wilco2009/Videopac-micro-SD-Cart/pictures/screen.png

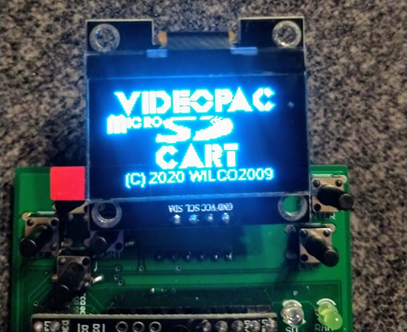
pictures/screen.png
