wilco2009/Videopac-micro-SD-Cart/(threads)

Thread 1 (2023-02-27):

Extra information for people creating the cartridge

JimmyDansbo, 2023-02-27:
Need a complete BOM for the cartridge ( I can't see what kind of RAM chip is used and I believe there is one or two resistors that do not have their value specified in the schematic ).
A guide to programming the CPLD and possibly even the Arduino the first time.
