wilco2009/Videopac-micro-SD-Cart/Schematics/Videopac SD cart 2.2 - alt.pdf

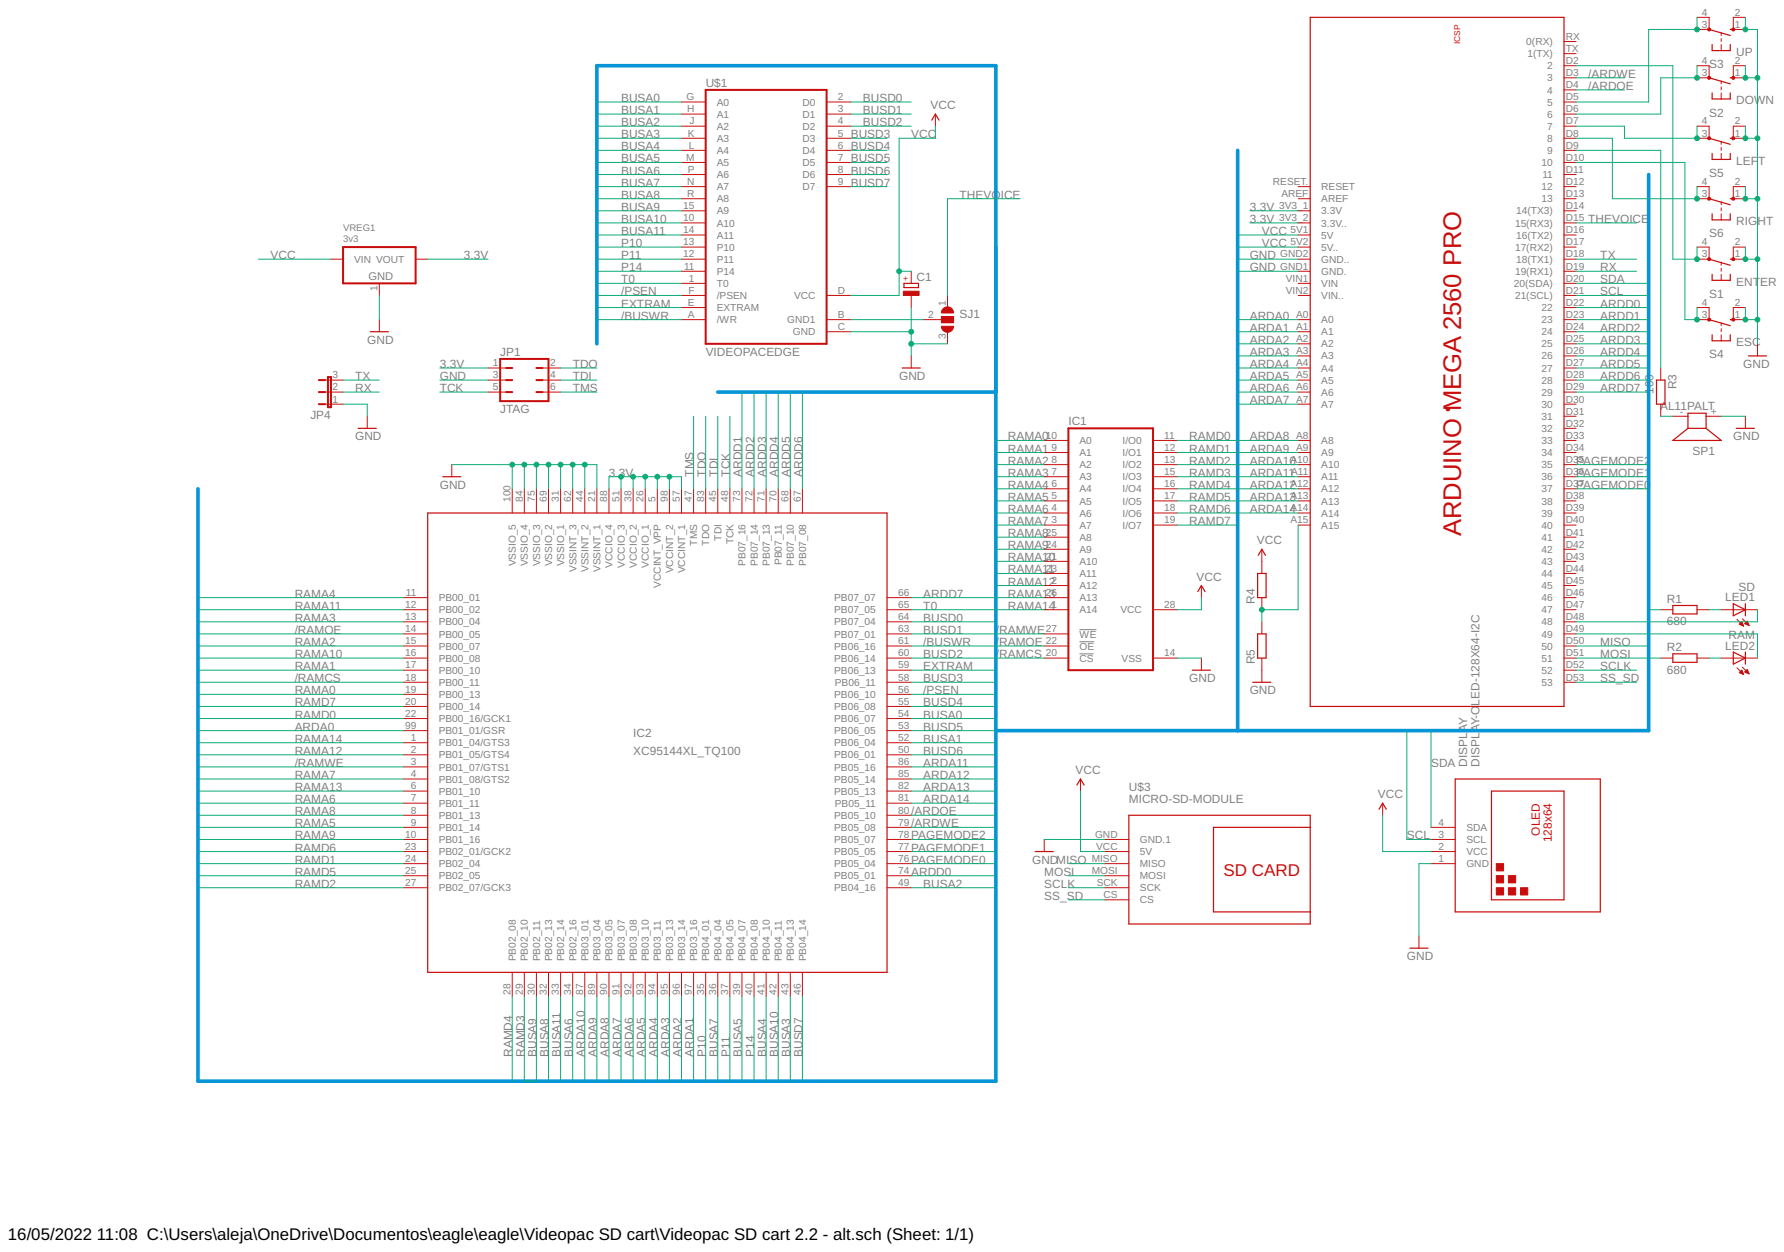
[picture p23: page 1]

BUSA4 | | 5 D4 BUSD4
L BUSA5 | A5 M | 6 D5 BUSD5

ARDA2 | ARDD3
ARDA3 | ARDD4
ARDA4 | ARDD5

RAMA1 | 59 PB06_14 EXTRAM | | GND
/RAMCS | 58 PB06_13 BUSD3
RAMA0 | 56 PB06_11 /PSEN
RAMD7 | 55 PB06_10 BUSD4
RAMD0 | 54 PB06_08 BUSA0
ARDA0 | 53 PB06_07 BUSD5
RAMA14 | 52 PB06_05 BUSA1 | VCC
RAMA12 | 50 PB06_04 BUSD6
/RAMWE | 86 PB06_01 ARDA11
RAMA7 | 85 PB05_16 ARDA12
RAMA13 | 82 PB05_14 ARDA13
RAMA6 | 81 PB05_13 ARDA14
RAMA8 | 80 PB05_11 /ARDOE

RAMD1 | 76 PB05_05 PAGEMODE0
RAMD5 | 74 PB05_04 ARDD0
RAMD2 | 49 PB05_01 BUSA2

16/05/2022 11:08 C:\Users\aleja\OneDrive\Documentos\eagle\eagle\Videopac SD cart\Videopac SD cart 2.2 - alt.sch (Sheet: 1/1)
