wilco2009/Videopac-micro-SD-Cart/Eagle/Videopac SD cart 2.2 - alt.brd

## EAGLE design Eagle/Videopac SD cart 2.2 - alt.brd (2022-12-12)

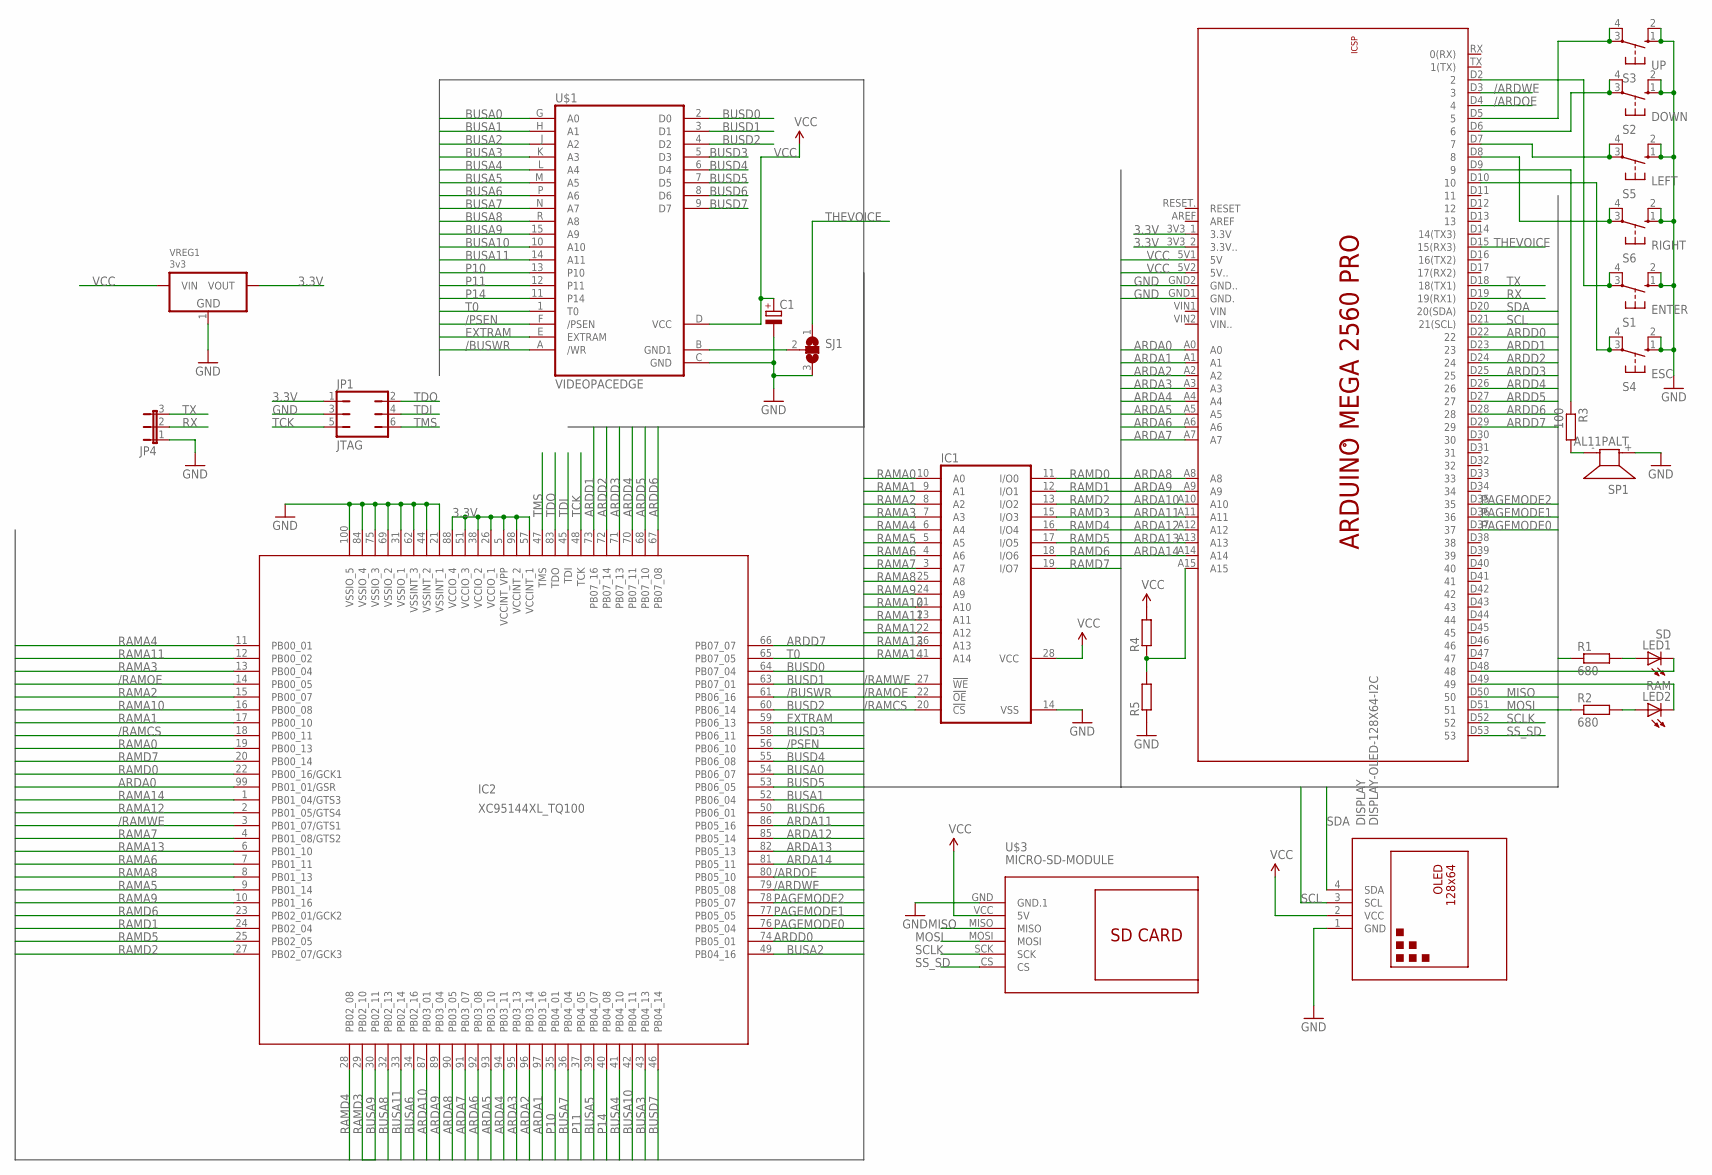
[picture p24: schematic Videopac SD cart 2.2 - alt.sch]

Parts:
C1: CPOL-EUE3.5-8; E3,5-8
DISPLAY: DISPLAY-OLED-128X64-I2C
IC1: 62256FPSOP28; SOP28
IC2: XC95144XL_TQ100; XC-TQ100
JP1: JTAG; JP3Q
JP4: JP2E; JP2
LED1: SD; LED3MM
LED2: RAM; LED3MM
R1, R2: 680; 0204/7
R3: 100; 0204/7
R4, R5: R-EU_0204/7; 0204/7
S1: ENTER; B3F-10XX
S2: DOWN; B3F-10XX
S3: UP; B3F-10XX
S4: ESC; B3F-10XX
S5: LEFT; B3F-10XX
S6: RIGHT; B3F-10XX
SJ1: SJ2W; SJ_2
SP1: AL11PALT; ALT
U$1: VIDEOPACEDGE; VIDEOPAC
U$2: ARDUINO_MEGA2560_PRO
U$3: MICRO-SD-MODULE; MICROSD-MODULE
VREG1: 3v3; SOT223

Connections:
3.3V: IC2.5 (VCCINT_VPP), IC2.26 (VCCIO_1), IC2.38 (VCCIO_2), IC2.51 (VCCIO_3), IC2.57 (VCCINT_1), IC2.88 (VCCIO_4), IC2.98 (VCCINT_2), JP1.1, U$2.3V3_1 (3.3V), U$2.3V3_2 (3.3V..), VREG1.2 (VOUT)
/ARDOE: IC2.80 (PB05_10), U$2.D4 (4)
/ARDWE: IC2.79 (PB05_08), U$2.D3 (3)
/BUSWR: IC2.61 (PB06_16), U$1.A (/WR)
/PSEN: IC2.56 (PB06_10), U$1.F (/PSEN)
/RAMCS: IC1.20 (!CS), IC2.18 (PB00_11)
/RAMOE: IC1.22 (!OE), IC2.14 (PB00_05)
/RAMWE: IC1.27 (!WE), IC2.3 (PB01_07/GTS1)
ARDA0: IC2.99 (PB01_01/GSR), U$2.A0
ARDA1: IC2.97 (PB03_16), U$2.A1
ARDA2: IC2.96 (PB03_14), U$2.A2
ARDA3: IC2.95 (PB03_13), U$2.A3
ARDA4: IC2.94 (PB03_11), U$2.A4
ARDA5: IC2.93 (PB03_10), U$2.A5
ARDA6: IC2.92 (PB03_08), U$2.A6
ARDA7: IC2.91 (PB03_07), U$2.A7
ARDA8: IC2.90 (PB03_05), U$2.A8
ARDA9: IC2.89 (PB03_04), U$2.A9
ARDA10: IC2.87 (PB03_01), U$2.A10
ARDA11: IC2.86 (PB05_16), U$2.A11
ARDA12: IC2.85 (PB05_14), U$2.A12
ARDA13: IC2.82 (PB05_13), U$2.A13
ARDA14: IC2.81 (PB05_11), U$2.A14
ARDD0: IC2.74 (PB05_01), U$2.D22 (22)
ARDD1: IC2.73 (PB07_16), U$2.D23 (23)
ARDD2: IC2.72 (PB07_14), U$2.D24 (24)
ARDD3: IC2.71 (PB07_13), U$2.D25 (25)
ARDD4: IC2.70 (PB07_11), U$2.D26 (26)
ARDD5: IC2.68 (PB07_10), U$2.D27 (27)
ARDD6: IC2.67 (PB07_08), U$2.D28 (28)
ARDD7: IC2.66 (PB07_07), U$2.D29 (29)
BUSA0: IC2.54 (PB06_07), U$1.G (A0)
BUSA1: IC2.52 (PB06_04), U$1.H (A1)
BUSA2: IC2.49 (PB04_16), U$1.J (A2)
BUSA3: IC2.43 (PB04_13), U$1.K (A3)
BUSA4: IC2.41 (PB04_10), U$1.L (A4)
BUSA5: IC2.39 (PB04_07), U$1.M (A5)
BUSA6: IC2.34 (PB02_16), U$1.P (A6)
BUSA7: IC2.36 (PB04_04), U$1.N (A7)
BUSA8: IC2.32 (PB02_13), U$1.R (A8)
BUSA9: IC2.30 (PB02_11), U$1.15 (A9)
BUSA10: IC2.42 (PB04_11), U$1.10 (A10)
BUSA11: IC2.33 (PB02_14), U$1.14 (A11)
BUSD0: IC2.64 (PB07_04), U$1.2 (D0)
BUSD1: IC2.63 (PB07_01), U$1.3 (D1)
BUSD2: IC2.60 (PB06_14), U$1.4 (D2)
BUSD3: IC2.58 (PB06_11), U$1.5 (D3)
BUSD4: IC2.55 (PB06_08), U$1.6 (D4)
BUSD5: IC2.53 (PB06_05), U$1.7 (D5)
BUSD6: IC2.50 (PB06_01), U$1.8 (D6)
BUSD7: IC2.46 (PB04_14), U$1.9 (D7)
BUTTON_A: S4.3, S4.4 (P1), U$2.D10 (10)
BUTTON_B: S1.3, S1.4 (P1), U$2.D2 (2)
BUTTON_DOWN: S2.3, S2.4 (P1), U$2.D6 (6)
BUTTON_LEFT: S5.3, S5.4 (P1), U$2.D7 (7)
BUTTON_RIGHT: S6.3, S6.4 (P1), U$2.D8 (8)
BUTTON_UP: S3.3, S3.4 (P1), U$2.D5 (5)
EXTRAM: IC2.59 (PB06_13), U$1.E (EXTRAM)
GND: C1.-, DISPLAY.1 (GND), IC1.14 (VSS), IC2.21 (VSSINT_1), IC2.31 (VSSIO_1), IC2.44 (VSSINT_2), IC2.62 (VSSINT_3), IC2.69 (VSSIO_2), IC2.75 (VSSIO_3), IC2.84 (VSSIO_4), IC2.100 (VSSIO_5), JP1.3, JP4.1, R5.1, S1.1 (S), S1.2 (S1), S2.1 (S), S2.2 (S1), S3.1 (S), S3.2 (S1), S4.1 (S), S4.2 (S1), S5.1 (S), S5.2 (S1), S6.1 (S), S6.2 (S1), SJ1.3, SP1.+ (1), U$1.C (GND), U$2.GND1 (GND.), U$2.GND2 (GND..), U$3.GND (GND.1), VREG1.1 (GND)
MISO: U$2.D50 (50), U$3.MISO
MOSI: U$2.D51 (51), U$3.MOSI
unnamed: LED1.A, R1.2
unnamed: LED2.A, R2.2
unnamed: LED1.K (C), U$2.D48 (48)
unnamed: LED2.K (C), U$2.D49 (49)
unnamed: R3.1, U$2.D9 (9)
unnamed: SJ1.2, U$1.B (GND1)
unnamed: R4.1, R5.2, U$2.A15
unnamed: R3.2, SP1.- (2)
P10: IC2.35 (PB04_01), U$1.13 (P10)
P11: IC2.37 (PB04_05), U$1.12 (P11)
P14: IC2.40 (PB04_08), U$1.11 (P14)
PAGEMODE0: IC2.76 (PB05_04), U$2.D37 (37)
PAGEMODE1: IC2.77 (PB05_05), U$2.D36 (36)
PAGEMODE2: IC2.78 (PB05_07), U$2.D35 (35)
RAMA0: IC1.10 (A0), IC2.19 (PB00_13)
RAMA1: IC1.9 (A1), IC2.17 (PB00_10)
RAMA2: IC1.8 (A2), IC2.15 (PB00_07)
RAMA3: IC1.7 (A3), IC2.13 (PB00_04)
RAMA4: IC1.6 (A4), IC2.11 (PB00_01)
RAMA5: IC1.5 (A5), IC2.9 (PB01_14)
RAMA6: IC1.4 (A6), IC2.7 (PB01_11)
RAMA7: IC1.3 (A7), IC2.4 (PB01_08/GTS2)
RAMA8: IC1.25 (A8), IC2.8 (PB01_13)
RAMA9: IC1.24 (A9), IC2.10 (PB01_16)
RAMA10: IC1.21 (A10), IC2.16 (PB00_08)
RAMA11: IC1.23 (A11), IC2.12 (PB00_02)
RAMA12: IC1.2 (A12), IC2.2 (PB01_05/GTS4)
RAMA13: IC1.26 (A13), IC2.6 (PB01_10)
RAMA14: IC1.1 (A14), IC2.1 (PB01_04/GTS3)
RAMD0: IC1.11 (I/O0), IC2.22 (PB00_16/GCK1)
RAMD1: IC1.12 (I/O1), IC2.24 (PB02_04)
RAMD2: IC1.13 (I/O2), IC2.27 (PB02_07/GCK3)
RAMD3: IC1.15 (I/O3), IC2.29 (PB02_10)
RAMD4: IC1.16 (I/O4), IC2.28 (PB02_08)
RAMD5: IC1.17 (I/O5), IC2.25 (PB02_05)
RAMD6: IC1.18 (I/O6), IC2.23 (PB02_01/GCK2)
RAMD7: IC1.19 (I/O7), IC2.20 (PB00_14)
RX: JP4.2, U$2.D19 (19(RX1))
SCL: DISPLAY.3 (SCL), U$2.D21 (21(SCL))
SCLK: U$2.D52 (52), U$3.SCK
SDA: DISPLAY.4 (SDA), U$2.D20 (20(SDA))
SS_SD: U$2.D53 (53), U$3.CS
T0: IC2.65 (PB07_05), U$1.1 (T0)
TCK: IC2.48 (TCK), JP1.5
TDI: IC2.45 (TDI), JP1.4
TDO: IC2.83 (TDO), JP1.2
THEVOICE: SJ1.1, U$2.D15 (15(RX3))
TMS: IC2.47 (TMS), JP1.6
TX: JP4.3, U$2.D18 (18(TX1))
VCC: C1.+, DISPLAY.2 (VCC), IC1.28 (VCC), R1.1, R2.1, R4.2, U$1.D (VCC), U$2.5V1 (5V), U$2.5V2 (5V..), U$3.VCC (5V), VREG1.3 (VIN)

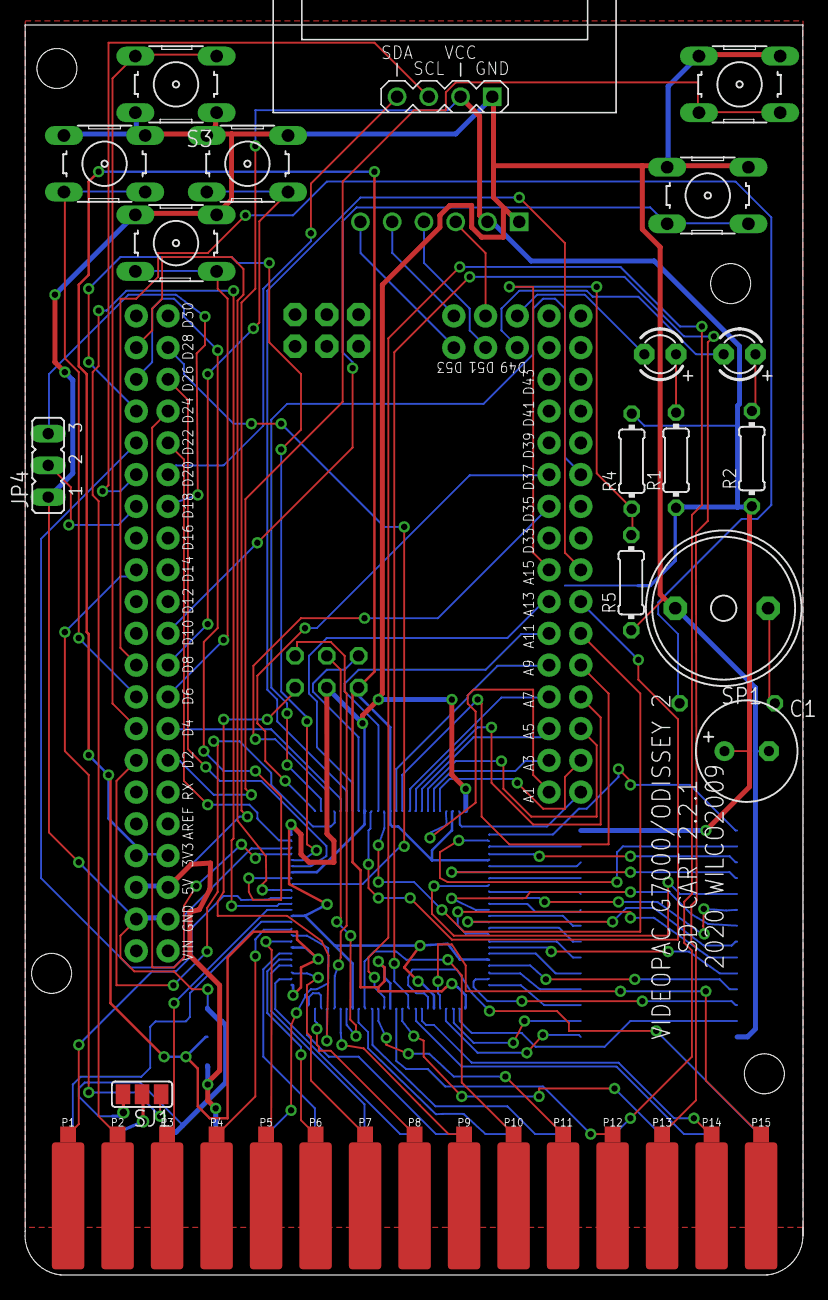
[picture p25: board Videopac SD cart 2.2 - alt.brd from above]

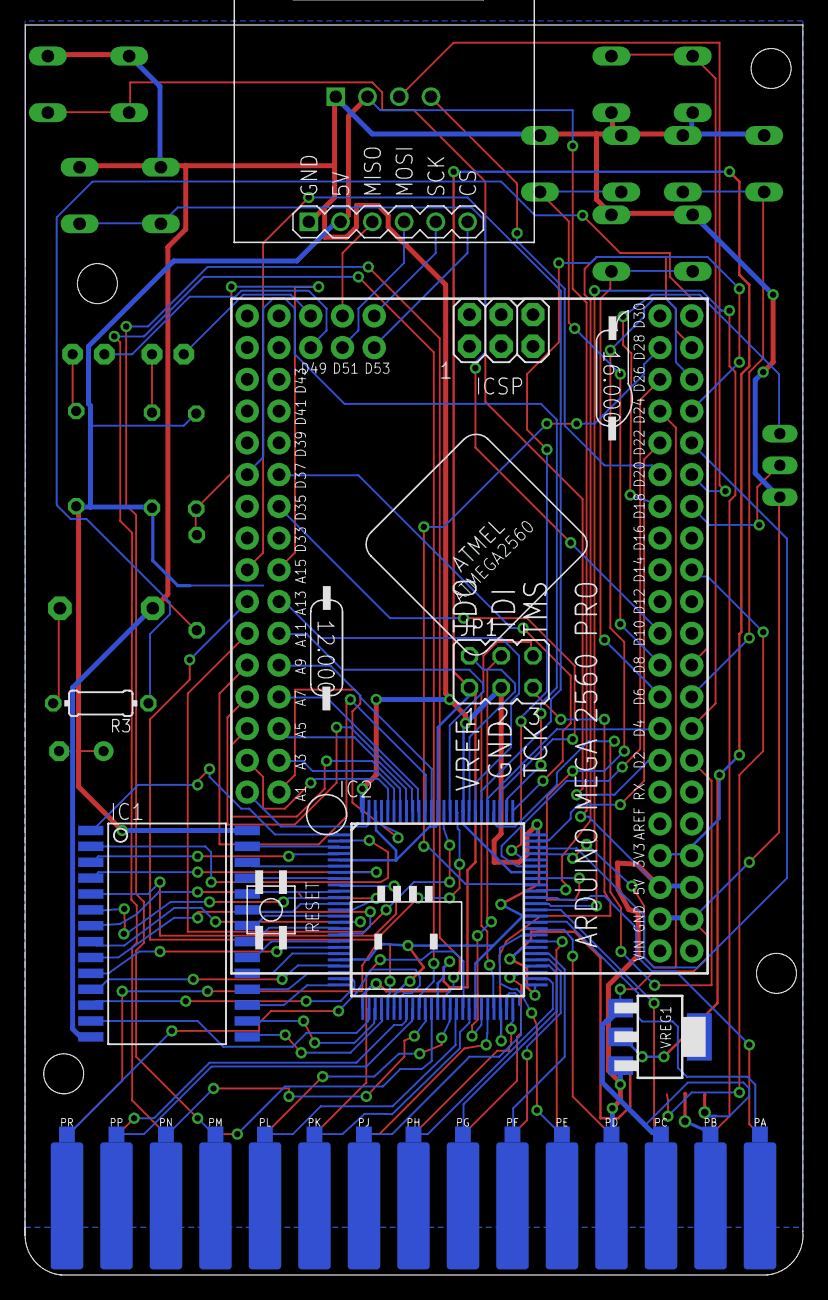
[picture p26: board Videopac SD cart 2.2 - alt.brd from below]

Board: 2 copper layers, 62.2 x 100.0 mm, 25 parts (7 on the bottom side), 111 nets.
