wilco2009/Videopac-micro-SD-Cart/Arduino/Videopac_SD_Card_Mega_2_1.07/images.h

PROGMEM const unsigned char selectgame[77] = {
    0x3e, 0x7f, 0x03, 0x7f, 0x3e, 0x3f, 0x00, 0x1f, 0x8e, 0xb1, 0x3f, 
    0x63, 0x03, 0x03, 0x03, 0x43, 0x0c, 0x80, 0x31, 0x9b, 0xbb, 0x01, 
    0x03, 0x03, 0x03, 0x03, 0x03, 0x0c, 0x80, 0x81, 0xb1, 0xbf, 0x01, 
    0x3e, 0x1f, 0x03, 0x0f, 0x03, 0x0c, 0x80, 0x81, 0xb1, 0xb5, 0x0f, 
    0x60, 0x03, 0x03, 0x03, 0x03, 0x0c, 0x80, 0xb9, 0xbf, 0xb1, 0x01, 
    0x63, 0x03, 0x03, 0x03, 0x43, 0x0c, 0x80, 0xb1, 0xb1, 0xb1, 0x01, 
    0x3e, 0x7f, 0x7f, 0x7f, 0x3e, 0x0c, 0x00, 0xbf, 0xb1, 0xb1, 0x3f
};


#define LOGO_width 128
#define LOGO_height 64
static const unsigned char LOGO[] PROGMEM = {
   0x00, 0x00, 0x00, 0x00, 0x00, 0x00, 0x00, 0x00, 0x00, 0x00, 0x00, 0x10,
   0x00, 0x00, 0x00, 0x00, 0x00, 0x1f, 0xf0, 0xbd, 0xf7, 0x81, 0xf7, 0x83,
   0x3f, 0xf0, 0x1e, 0x10, 0x00, 0xdc, 0x01, 0x00, 0x00, 0x3e, 0xf8, 0xbc,
   0xf7, 0x83, 0xf7, 0xc3, 0x7f, 0xf0, 0x3e, 0x38, 0x00, 0xde, 0x03, 0x00,
   0x00, 0x3c, 0xf8, 0xbc, 0xf7, 0x87, 0xf7, 0xe3, 0xff, 0xf0, 0x7e, 0x38,
   0x00, 0xdf, 0x07, 0x00, 0x00, 0x7c, 0x7c, 0xbc, 0xf7, 0x8f, 0xf7, 0xf3,
   0xff, 0xf1, 0x7e, 0x7c, 0x80, 0xdf, 0x0f, 0x00, 0x00, 0x78, 0x3c, 0xbc,
   0x87, 0x9f, 0x07, 0xf8, 0xf1, 0xf3, 0xf8, 0x7c, 0xc0, 0x8f, 0x03, 0x00,
   0x00, 0xf8, 0x3e, 0xbc, 0x07, 0x9f, 0xf7, 0xfb, 0xe0, 0xf3, 0x7e, 0xfa,
   0xc0, 0x07, 0x01, 0x00, 0x00, 0xf0, 0x1f, 0xbc, 0x07, 0x9e, 0xf7, 0x7b,
   0xc0, 0xf3, 0x7e, 0xfe, 0xc0, 0x03, 0x00, 0x00, 0x00, 0xf0, 0x1d, 0xbc,
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
    0b00111100, 
    0b00100100, 
    0b11100111, 
    0b11111111, 
    0b01111110
};

static const unsigned char PROGMEM explosion_img[] U8X8_PROGMEM = {
    0b01101100, 
    0b11011000, 
    0b10110110, 
    0b01100110, 
    0b11001100, 
    0b11111011, 
    0b01100111, 
    0b00001110
};
